fieldkit/darwin-radio/readme.md

DARWIN-RADIO

Experimental development repo for next-generation FieldKit hardware.

-- This hardware is experimental and still under development, the designs may contain errors. --
