fieldkit/darwin-radio/darwin-radio.pdf

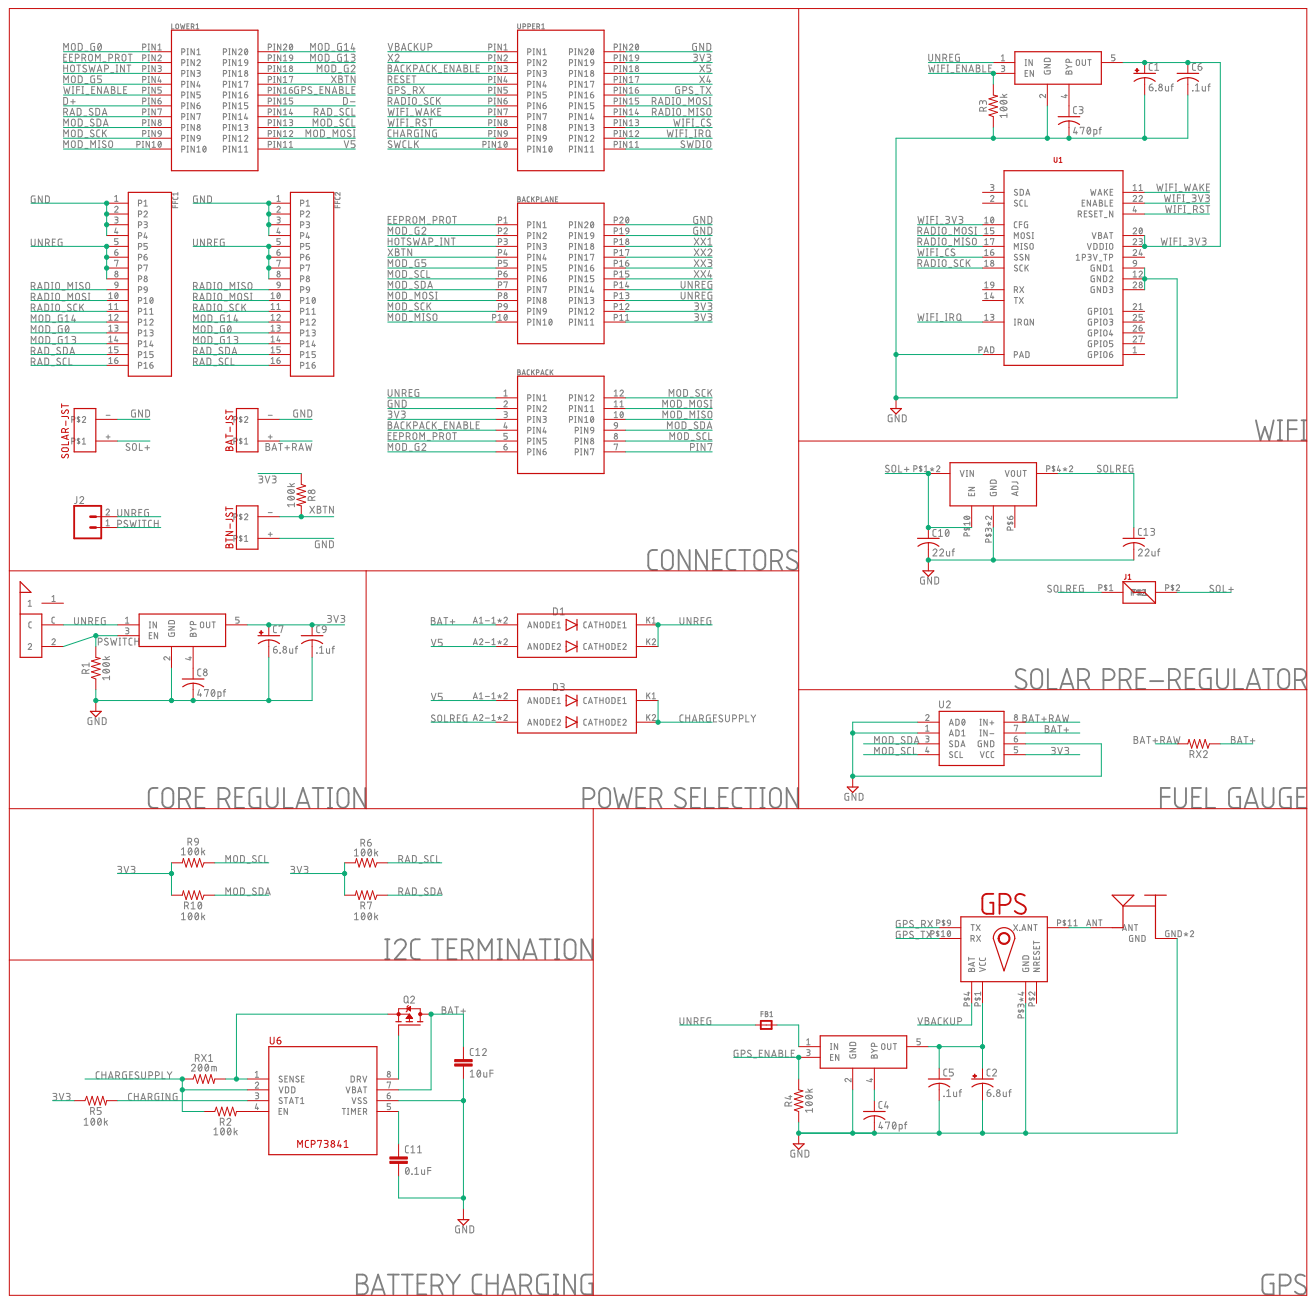
[picture p1: page 1]
