fieldkit/darwin-radio/darwin-radio.brd

## EAGLE design darwin-radio.brd (2020-08-07)

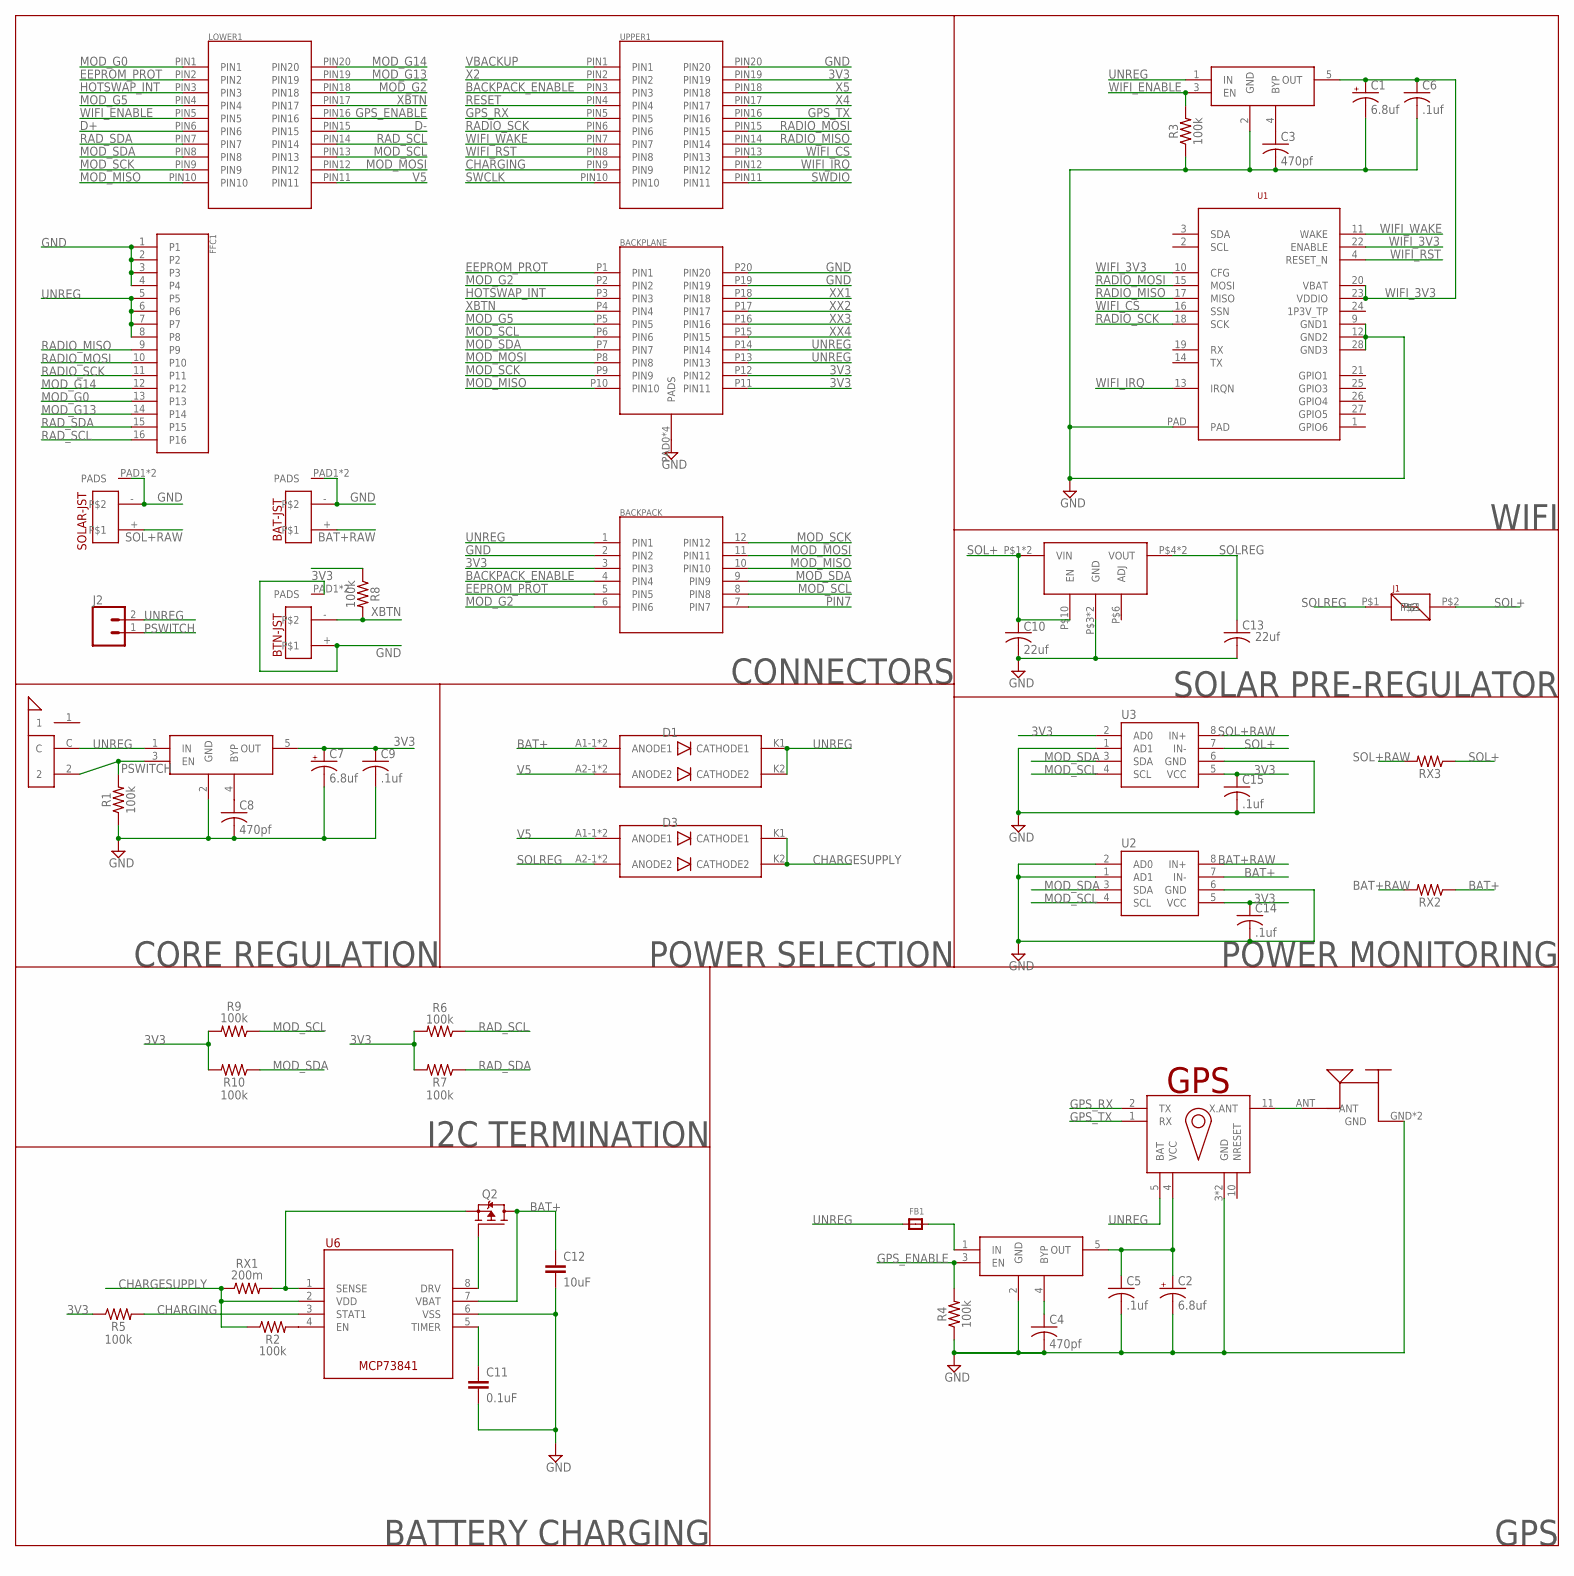
[picture p2: schematic darwin-radio.sch]

Parts:
BACKPACK: 2X6-HEADERSDS; 12PH
BACKPLANE: M55-6102042R
BAT-JST: B2B-PH-SM4-TB
BTN-JST: B2B-PH-SM4-TB
C1, C2, C7: 6.8uf; A/3216-18R
C3, C4, C8: 470pf; C0603K
C5, C6, C9, C14, C15: .1uf; C0603K
C10, C13: 22uf; C0603K
C11: 0.1uF; 0603
C12: 10uF; 0603
D1, D3: V10KL45DUHM3/H
FB1: FERRITE0805; 0805
FFC1: 505110-1692
J1: S1911-46R
J2: CONN_02LOCK_LONGPADS; 1X02_LOCK_LONGPADS
LOWER1: MOLEX-15-91-2200; 20PH
Q2: NDS8434; SO08-IRF
R1, R2, R3, R4, R5, R6, R7, R8, R9, R10: 100k; 0603
REG1: V78E06-1000-SMT-TR
RX1: 200m; R2512
RX2, RX3: 100M; R2512
SOLAR-JST: B2B-PH-SM4-TB
U1: ATWINC
U2, U3: INA219; SOIC127P599X175-8N
U6: MCP7384X; SOP65P490X110-8
U$1: FGPMMOPA6HL80; L80-M39
U$2, U$3, U$4: MIC5219-3.3YM5-TR; SOT95P280X145-5
U$5: SSAJ110100
U$11: 2337019-1
UPPER1: MOLEX-15-91-2200; 20PH

Connections:
3V3: BACKPACK.3 (PIN3), BACKPLANE.P11 (PIN11), BACKPLANE.P12 (PIN12), C7.+, C9.1, C14.1, C15.1, R5.1, R6.2, R7.2, R8.1, R9.2, R10.2, U2.5 (VCC), U3.2 (AD0), U3.5 (VCC), U$4.5 (OUT), UPPER1.PIN19
BACKPACK_ENABLE: BACKPACK.4 (PIN4), UPPER1.PIN3
BAT+: C12.1, D1.A1-1 (ANODE1), D1.A1-2 (ANODE1), Q2.5 (D), Q2.6 (D), Q2.7 (D), Q2.8 (D), RX2.1, U2.7 (IN-), U6.7 (VBAT)
BAT+RAW: BAT-JST.+, RX2.2, U2.8 (IN+)
CHARGESUPPLY: D3.K1 (CATHODE1), D3.K2 (CATHODE2), R2.1, RX1.1, U6.2 (VDD)
CHARGING: R5.2, U6.3 (STAT1), UPPER1.PIN9
D+: LOWER1.PIN6
D-: LOWER1.PIN15
EEPROM_PROT: BACKPACK.5 (PIN5), BACKPLANE.P1 (PIN1), LOWER1.PIN2
GND: BACKPACK.2 (PIN2), BACKPLANE.P19 (PIN19), BACKPLANE.P20 (PIN20), BACKPLANE.PAD0 (PADS), BACKPLANE.PAD1 (PADS), BACKPLANE.PAD2 (PADS), BACKPLANE.PAD3 (PADS), BAT-JST.-, BAT-JST.PAD1 (PADS), BAT-JST.PAD2 (PADS), BTN-JST.+, BTN-JST.PAD1 (PADS), BTN-JST.PAD2 (PADS), C1.-, C2.-, C3.2, C4.2, C5.2, C6.2, C7.-, C8.2, C9.2, C10.2, C11.2, C12.2, C13.2, C14.2, C15.2, FFC1.1, FFC1.2, FFC1.3, FFC1.4, R1.1, R3.1, R4.1, REG1.P$3 (GND), REG1.P$7 (GND), SOLAR-JST.-, SOLAR-JST.PAD1 (PADS), SOLAR-JST.PAD2 (PADS), U1.9 (GND1), U1.12 (GND2), U1.28 (GND3), U1.PAD, U2.1 (AD1), U2.2 (AD0), U2.6 (GND), U3.1 (AD1), U3.6 (GND), U6.6 (VSS), U$1.3 (GND), U$1.12 (GND), U$2.2 (GND), U$3.2 (GND), U$4.2 (GND), U$11.GND, U$11.GND2 (GND), UPPER1.PIN20
GPS_ENABLE: LOWER1.PIN16, R4.2, U$2.3 (EN)
GPS_RX: U$1.2 (TX), UPPER1.PIN5
GPS_TX: U$1.1 (RX), UPPER1.PIN16
HOTSWAP_INT: BACKPLANE.P3 (PIN3), LOWER1.PIN3
MOD_G0: FFC1.13, LOWER1.PIN1
MOD_G2: BACKPACK.6 (PIN6), BACKPLANE.P2 (PIN2), LOWER1.PIN18
MOD_G5: BACKPLANE.P5 (PIN5), LOWER1.PIN4
MOD_G13: FFC1.14, LOWER1.PIN19
MOD_G14: FFC1.12, LOWER1.PIN20
MOD_MISO: BACKPACK.10 (PIN10), BACKPLANE.P10 (PIN10), LOWER1.PIN10
MOD_MOSI: BACKPACK.11 (PIN11), BACKPLANE.P8 (PIN8), LOWER1.PIN12
MOD_SCK: BACKPACK.12 (PIN12), BACKPLANE.P9 (PIN9), LOWER1.PIN9
MOD_SCL: BACKPACK.8 (PIN8), BACKPLANE.P6 (PIN6), LOWER1.PIN13, R9.1, U2.4 (SCL), U3.4 (SCL)
MOD_SDA: BACKPACK.9 (PIN9), BACKPLANE.P7 (PIN7), LOWER1.PIN8, R10.1, U2.3 (SDA), U3.3 (SDA)
unnamed: C3.1, U$3.4 (BYP)
unnamed: C4.1, U$2.4 (BYP)
unnamed: C2.+, C5.1, U$1.4 (VCC), U$2.5 (OUT)
unnamed: U$1.11 (X.ANT), U$11.ANT
unnamed: R2.2, U6.4 (EN)
unnamed: C8.1, U$4.4 (BYP)
unnamed: FB1.2, U$2.1 (IN)
unnamed: Q2.1 (S), Q2.2 (S), Q2.3 (S), RX1.2, U6.1 (SENSE)
unnamed: Q2.4 (G), U6.8 (DRV)
unnamed: C11.1, U6.5 (TIMER)
PIN7: BACKPACK.7 (PIN7)
PSWITCH: J2.1, R1.2, U$4.3 (EN), U$5.2
RADIO_MISO: FFC1.9, U1.17 (MISO), UPPER1.PIN14
RADIO_MOSI: FFC1.10, U1.15 (MOSI), UPPER1.PIN15
RADIO_SCK: FFC1.11, U1.18 (SCK), UPPER1.PIN6
RAD_SCL: FFC1.16, LOWER1.PIN14, R6.1
RAD_SDA: FFC1.15, LOWER1.PIN7, R7.1
RESET: UPPER1.PIN4
SOL+: C10.1, J1.P$2, REG1.P$1 (VIN), REG1.P$2 (VIN), REG1.P$10 (EN), RX3.1, U3.7 (IN-)
SOL+RAW: RX3.2, SOLAR-JST.+, U3.8 (IN+)
SOLREG: C13.1, D3.A2-1 (ANODE2), D3.A2-2 (ANODE2), J1.P$1, REG1.P$4 (VOUT), REG1.P$5 (VOUT)
SWCLK: UPPER1.PIN10
SWDIO: UPPER1.PIN11
UNREG: BACKPACK.1 (PIN1), BACKPLANE.P13 (PIN13), BACKPLANE.P14 (PIN14), D1.K1 (CATHODE1), D1.K2 (CATHODE2), FB1.1, FFC1.5, FFC1.6, FFC1.7, FFC1.8, J2.2, U$1.5 (BAT), U$3.1 (IN), U$4.1 (IN), U$5.C
V5: D1.A2-1 (ANODE2), D1.A2-2 (ANODE2), D3.A1-1 (ANODE1), D3.A1-2 (ANODE1), LOWER1.PIN11
VBACKUP: UPPER1.PIN1
WIFI_3V3: C1.+, C6.1, U1.10 (CFG), U1.20 (VBAT), U1.22 (ENABLE), U1.23 (VDDIO), U$3.5 (OUT)
WIFI_CS: U1.16 (SSN), UPPER1.PIN13
WIFI_ENABLE: LOWER1.PIN5, R3.2, U$3.3 (EN)
WIFI_IRQ: U1.13 (IRQN), UPPER1.PIN12
WIFI_RST: U1.4 (RESET_N), UPPER1.PIN8
WIFI_WAKE: U1.11 (WAKE), UPPER1.PIN7
X2: UPPER1.PIN2
X4: UPPER1.PIN17
X5: UPPER1.PIN18
XBTN: BACKPLANE.P4 (PIN4), BTN-JST.-, LOWER1.PIN17, R8.2
XX1: BACKPLANE.P18 (PIN18)
XX2: BACKPLANE.P17 (PIN17)
XX3: BACKPLANE.P16 (PIN16)
XX4: BACKPLANE.P15 (PIN15)

Notes on the sheet:
BATTERY CHARGING
POWER MONITORING
WIFI
POWER SELECTION
CORE REGULATION
CONNECTORS
GPS
I2C TERMINATION
SOLAR PRE-REGULATOR

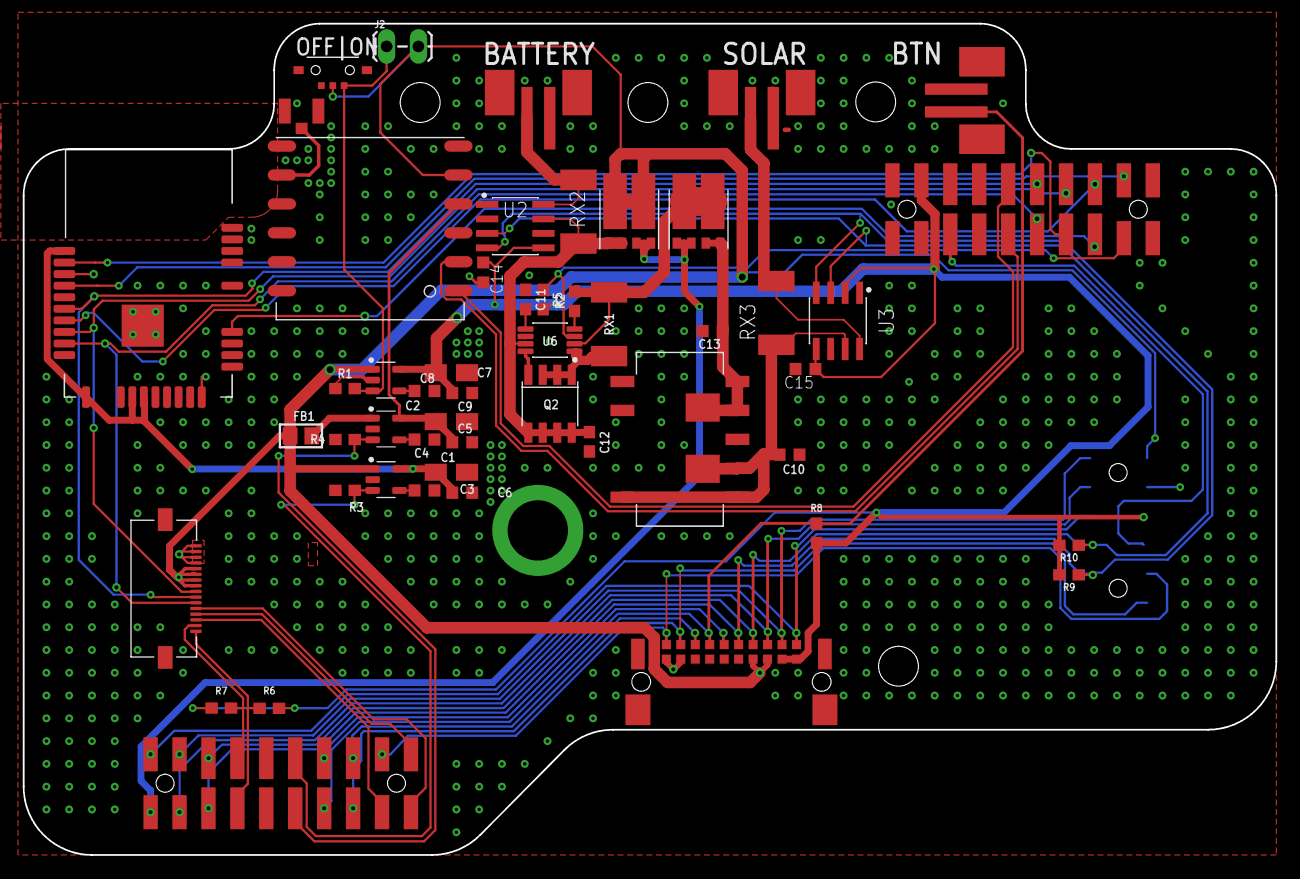
[picture p3: board darwin-radio.brd from above]

Board: 2 copper layers, 110.0 x 73.0 mm, 53 parts (1 on the bottom side), 50 nets.
