fieldkit/darwin-radio/(commit log)

2019-06-10 Basic Lash-Up.
    [darwin-radio.brd, darwin-radio.sch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]
2019-07-05 Fixed Wifi enable, Radio Pullups, BAT+ connection on charger, and internal layer shorts to various vias.
    [darwin-radio.brd, darwin-radio.sch]
2019-07-05 TA2 CAM files generated.
    [darwin-radio.brd]
2019-09-03 Added external button header. added mounting point for single 'backpack' module. Panelized. PA1.
    [darwin-radio-panel.brd, darwin-radio.brd, darwin-radio.sch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]
2020-01-16 Added solar pre-regulation, deprecated fuel gauge, added current sense, replaced current sense resistors, lots of routing changes, new panel.
    [darwin-radio-panel.brd, darwin-radio-panel2.brd, darwin-radio-panel3.brd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]
2020-02-11 Added power switch headers.
    [blankpanel.brd, darwin-radio-panel4.brd, darwin-radio.brd, darwin-radio.sch]
2020-02-18 Increased screw hole size and clearance diameter.
    [darwin-radio.brd]
2020-02-18 Screw holes to 3.5MM for ANSI-ASME compliance.
    [darwin-radio.brd]
2020-05-01 Toughened up connector footprints, cleaned up schematic, added schematic PDF.
    [darwin-radio.brd, darwin-radio.sch]
2020-08-07 Removed unwanted panel files and changed unpopulated panel template.
    [blankpanel.brd, darwin-radio-panel3.brd, darwin-radio-panel4.brd]
2020-08-07 Transitioned from 4 to 2 layers. Added solar power monitor. Changed GPS to L80-M39.
    [darwin-radio.brd, darwin-radio.sch]
